lamerous/mc-system/docs/PCB/png/PCB_PCB_BZHCH_CLOCK-copy_2025-10-13.png

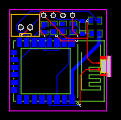
docs/PCB/png/PCB_PCB_BZHCH_CLOCK-copy_2025-10-13.png
