lamerous/mc-system/docs/schemes/Schematic_BZHCH_CLOCK_2025-10-13.pdf

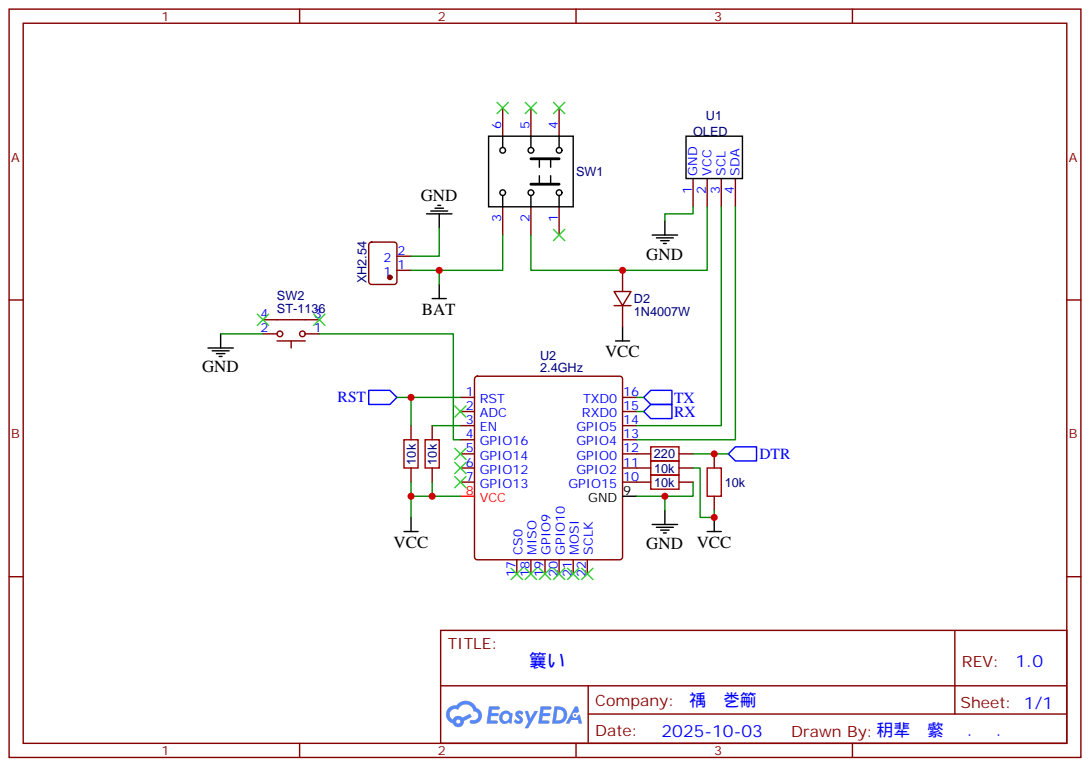
[picture p11: page 1]
