lamerous/mc-system/docs/schemes/Schematic_BZHCH_SENSOR_2025-10-13.pdf

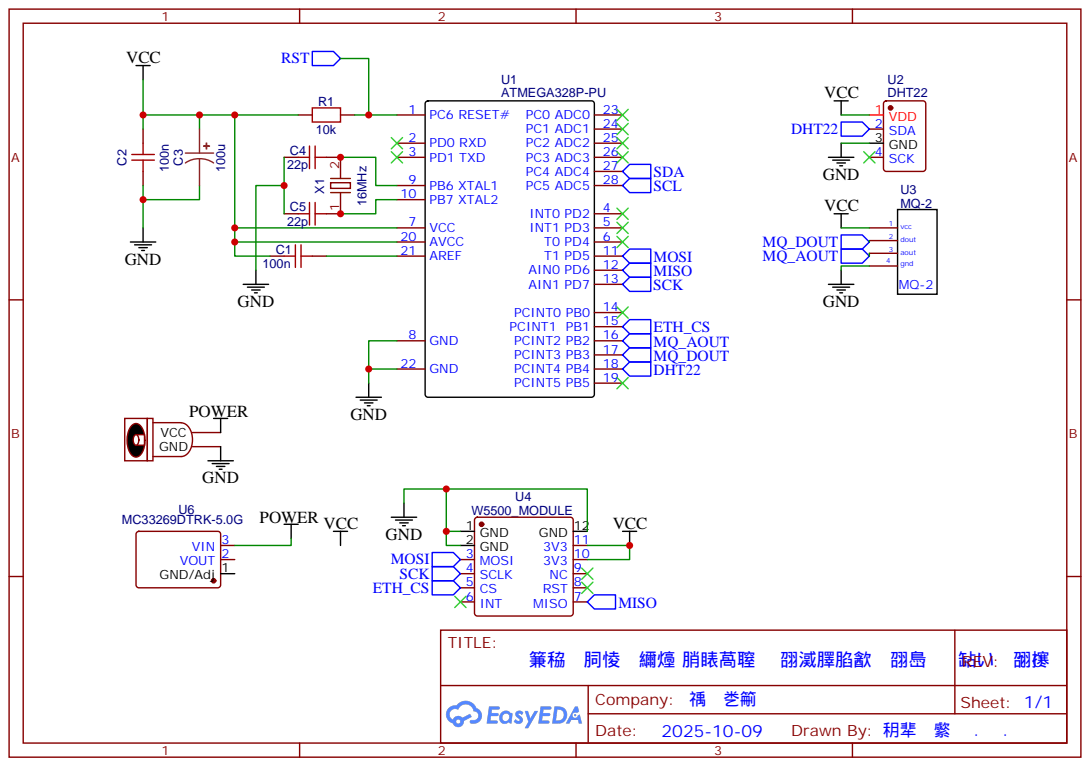
[picture p12: page 1]
