lamerous/mc-system/docs/PCB/pcb.pdf

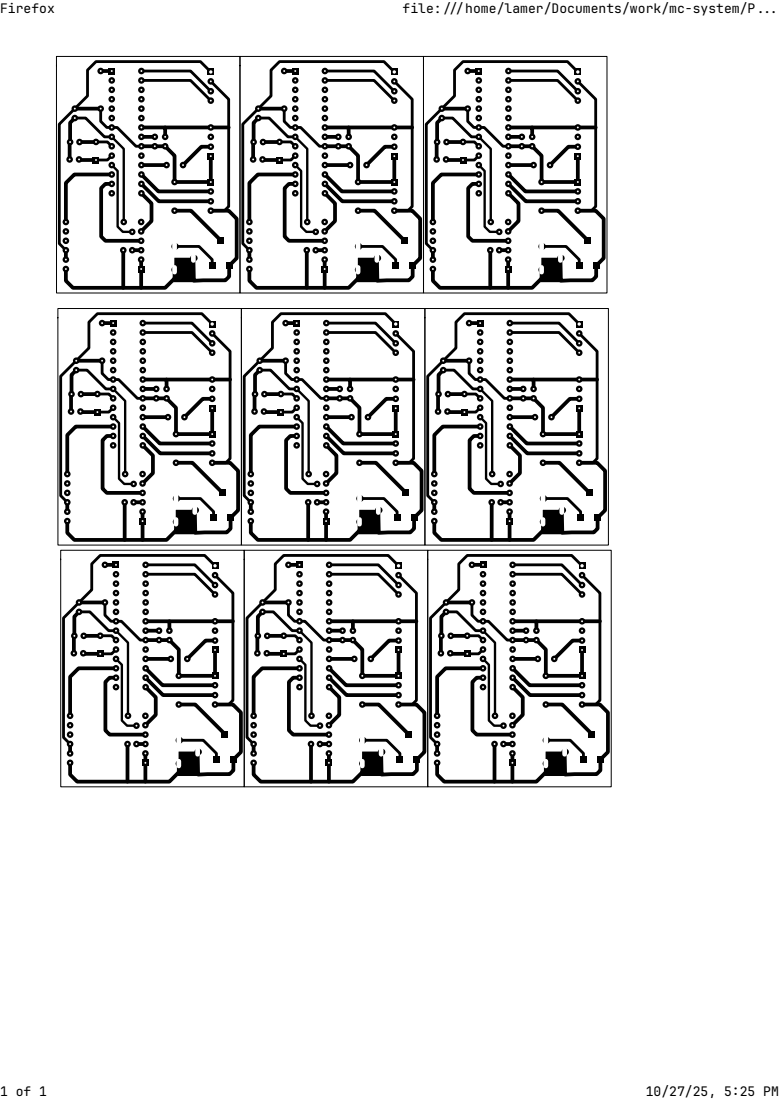
[picture p13: page 1]
Firefox; file:home/lamer/Documents/work/mc-system/P
