lamerous/mc-system/docs/PCB/pdf/PCB_PCB_BZHCH_CLOCK-copy_2025-10-13.pdf

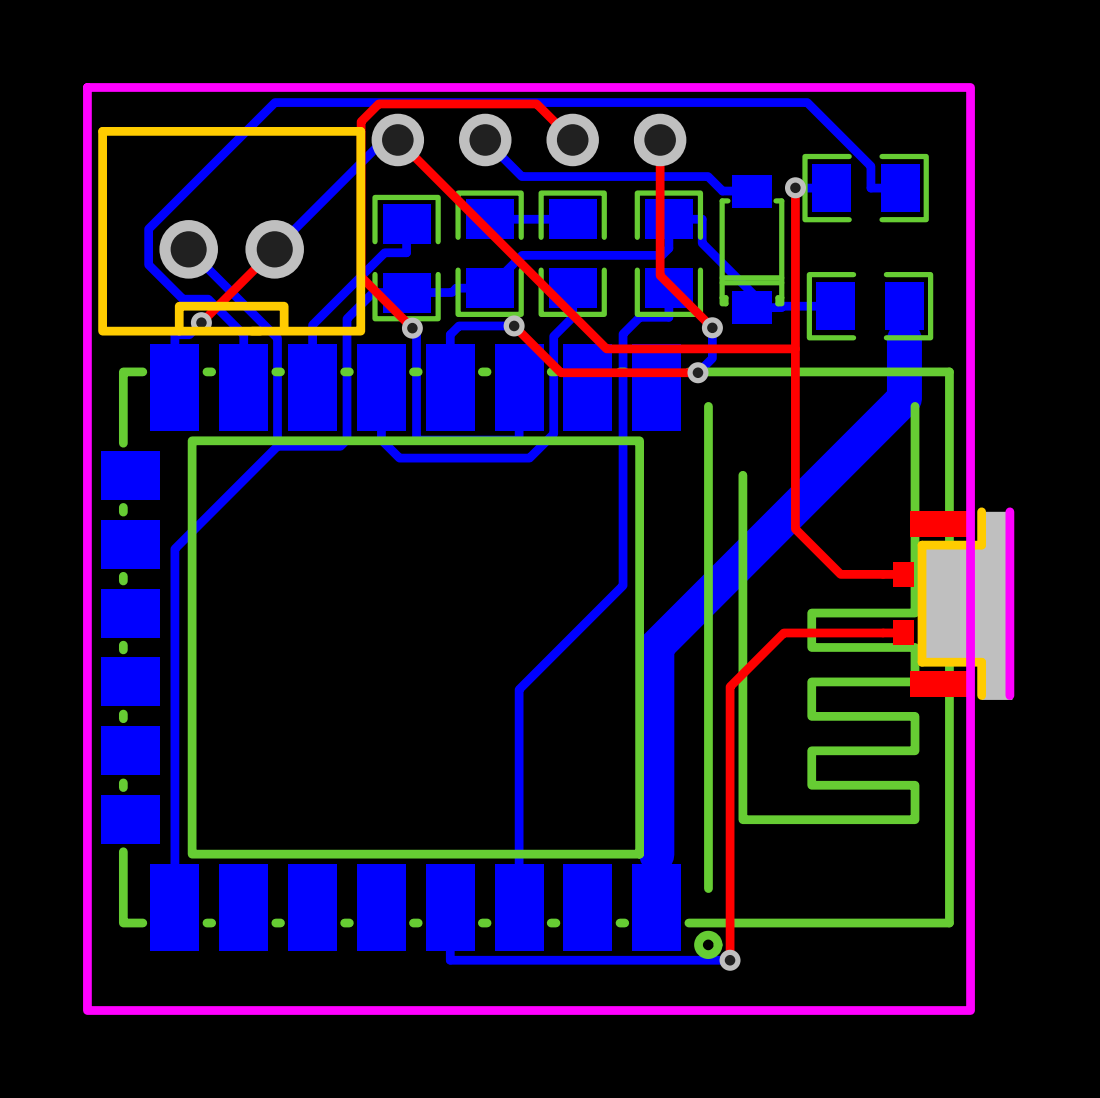
[picture p14: page 1]
