lamerous/mc-system/docs/PCB/pdf/PCB_PCB_BZHCH_SENSOR_2025-10-13.pdf

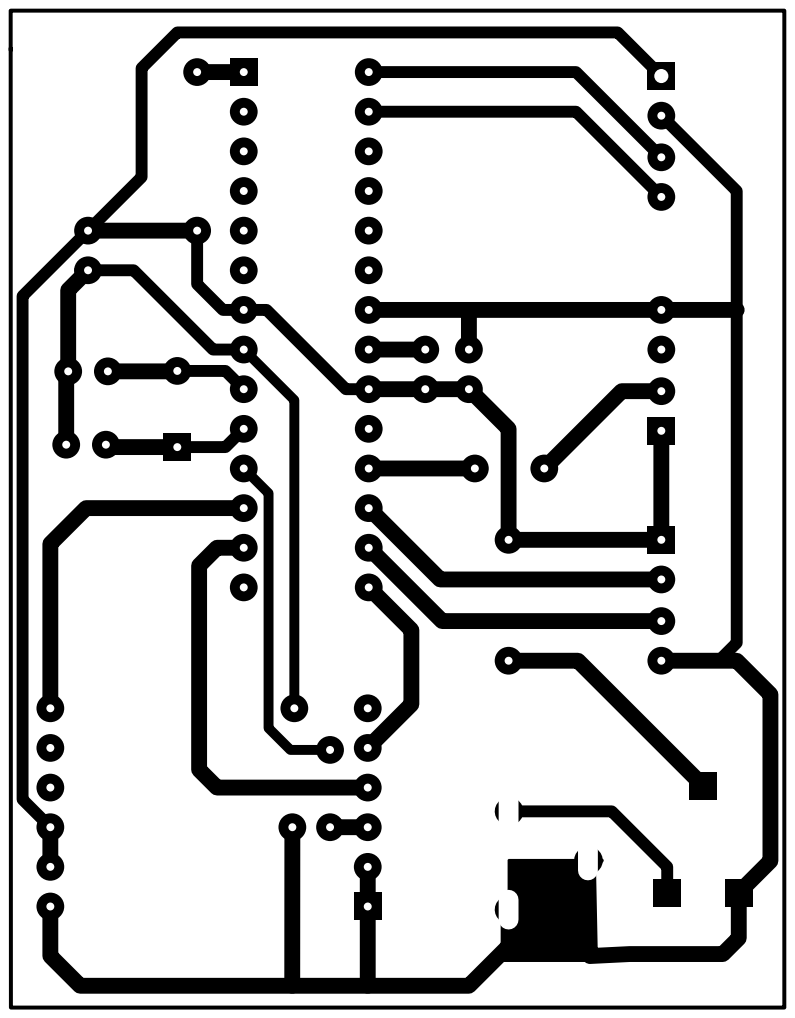
[picture p15: page 1]
